tigakub/qd-project/QD_V1.0_BOM.pdf

### Core Materials

Part ID | Picture | Item | Description | Source Link | Price | Quantity | Subtotal | Total
A Arduino MKR | | Wifi 1010 | Microcontroller | Arduino (https://store-usa.arduino.cc/products/arduino-mkr-wifi-1010?queryID=undefined&selectedStore=us) | $32.81 | 1 | $32.81
B | | Dynamixel Shield for Arduino MKR Series | Servo driver board | Robotis (https://www.robotis.us/controllers-2/) | $19.10 | 1 | $19.10

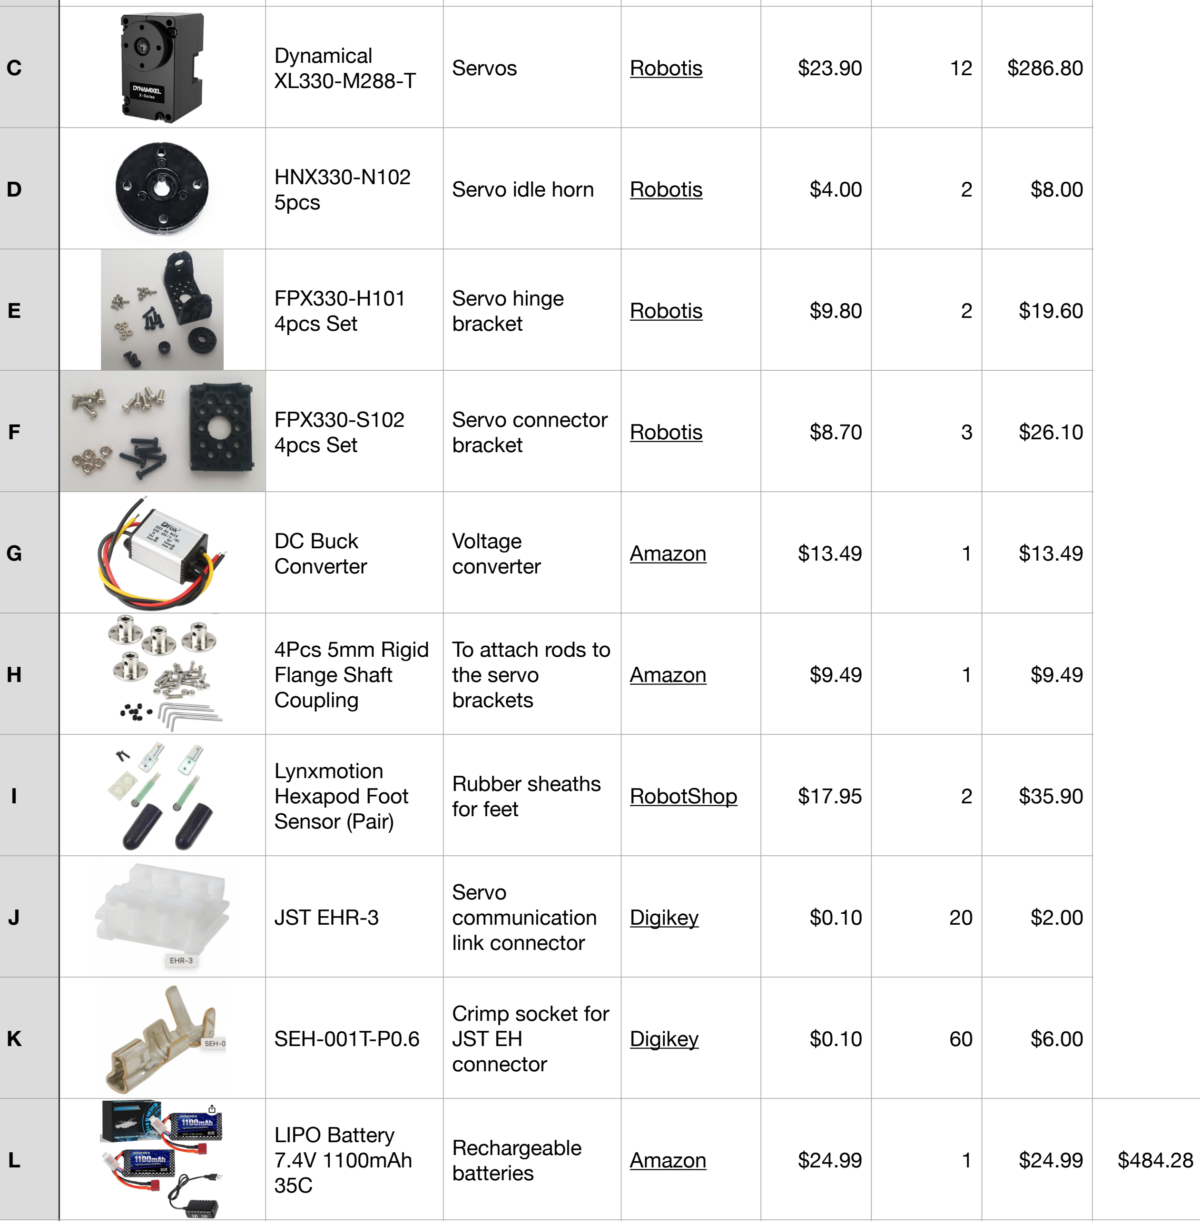
[picture p1: figure]
C Dynamical; Servos; Robotis (https://www.robotis.us/dynamixel-xl330-m288-t/); D HNX330-N102; 5pcs; Servo idle horn; Robotis (https://www.robotis.us/horns/); E FPX330-H101; 4pcs Set; Servo hinge bracket; Robotis (https://www.robotis.us/frames/); F FPX330-S102; Servo connector bracket; G DC Buck; Converter; Voltage converter; Amazon (https://www.amazon.com/gp/product/B00C0KL1OM/ref=ppx_yo_dt_b_search_asin_image?ie=UTF8&th=1); Lynxmotion Hexapod Foot Sensor (Pair); Rubber sheaths for feet; RobotShop (https://www.robotshop.com/products/lynxmotion-hexapod-foot-sensor-pair); J JST EHR-3; Servo communication link connector; Digikey (https://www.digikey.com/en/products/detail/jst-sales-america-inc/EHR-3/527225); LIPO Battery 7.4V 1100mAh 35C; Rechargeable batteries; Amazon (https://www.amazon.com/gp/product/B08N4RHMNH/ref=ppx_yo_dt_b_search_asin_title?ie=UTF8&th=1)

H | | 4Pcs 5mm Rigid Flange Shaft Coupling | To attach rods to the servo brackets | Amazon (https://www.amazon.com/gp/product/B07L1FMBBC/ref=ppx_yo_dt_b_search_asin_title?ie=UTF8&psc=1) | $9.49 | 1 | $9.49
K SEH-001T-P0.6 | | | Crimp socket for JST EH connector | Digikey (https://www.digikey.com/en/products/detail/jst-sales-america-inc/SEH-001T-P0-6/527267) | $0.10 | 60 | $6.00

### QD V1.0 BOM

1

### Bulk Materials

Part ID | Picture | Item | Description | Source Link | Price | Quantity | Subtotal | Total

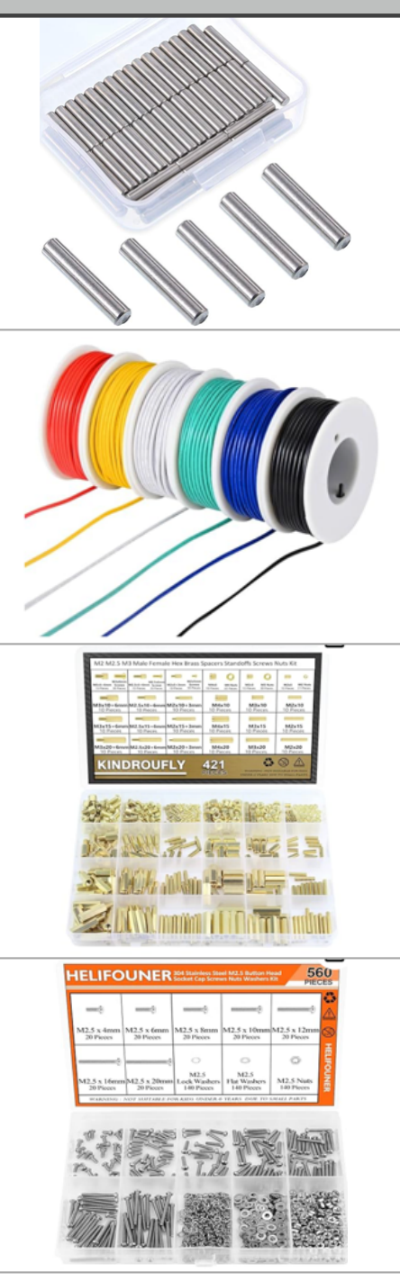
[picture p2: figure]

M | | 50Pcs 5mm x 25mm Dowel Pin Shelf Support Pegs | Steel rods for feet | Amazon (https://www.amazon.com/gp/product/B07FFNTDQF/ref=ppx_yo_dt_b_search_asin_title?ie=UTF8&th=1) | $8.99 | 1 | $8.99
N | | 22 AWG Wire | Electrical wire | Amazon (https://www.amazon.com/gp/product/B0815ZDD5H/ref=ppx_yo_dt_b_search_asin_title?ie=UTF8&th=1) | $14.99 | 1 | $14.99
O | | 421 Pieces M2 M2.5 M3 Male Female Hex Standoffs | Spacers to mount controller and buck converter | Amazon (https://www.amazon.com/gp/product/B0B3Y49J37/ref=ppx_yo_dt_b_search_asin_title?ie=UTF8&th=1) | $22.99 | 1 | $22.99
P | | 560 piece button head socket cap metric screws washers and | Screws washers nuts | Amazon (https://www.amazon.com/gp/product/B0B6HX3798/ref=ppx_yo_dt_b_search_asin_title?ie=UTF8&th=1) | $11.99 | 1 | $11.99 | $58.96

nuts
$543.24

### QD V1.0 BOM

2
