tigakub/qd-project/model/Torso_Hull.stl

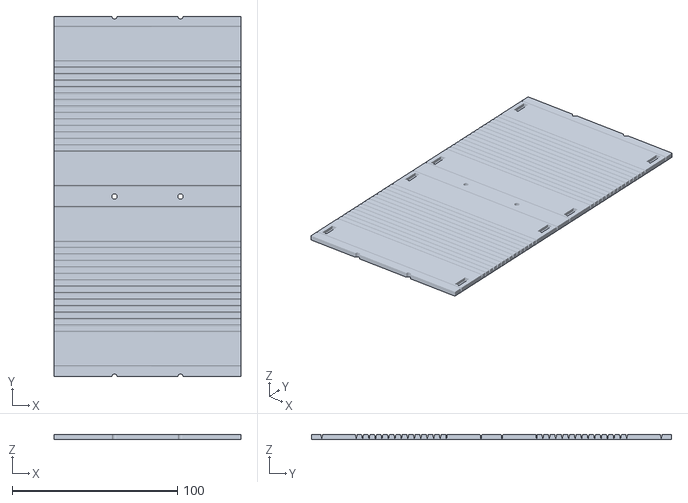
[picture p3: CAD file, 2023-11-29]
model/Torso_Hull.stl
113.0 x 218.1 x 3.00
