tigakub/qd-project/model/Foot.stl

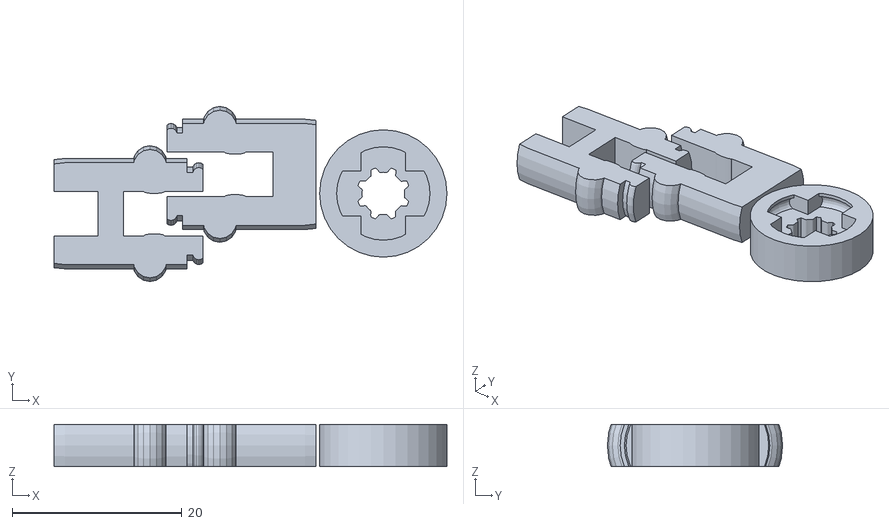
[picture p4: CAD file, 2023-11-29]
model/Foot.stl
46.3 x 20.6 x 5.00
