tigakub/qd-project/model/Central_Frame.stl

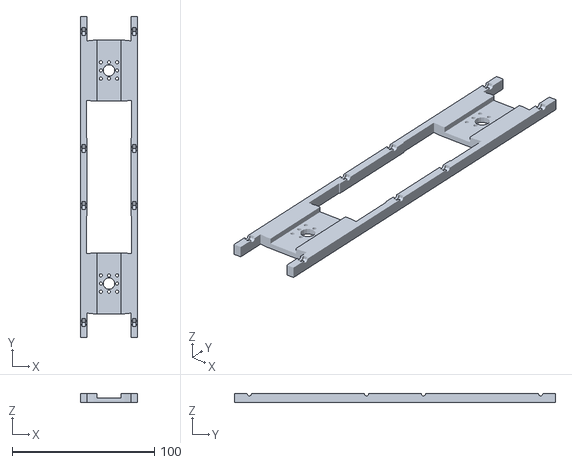
[picture p5: CAD file, 2023-11-29]
model/Central_Frame.stl
40.0 x 225.9 x 6.00
