tigakub/qd-project/model/Torso_End_Caps.stl

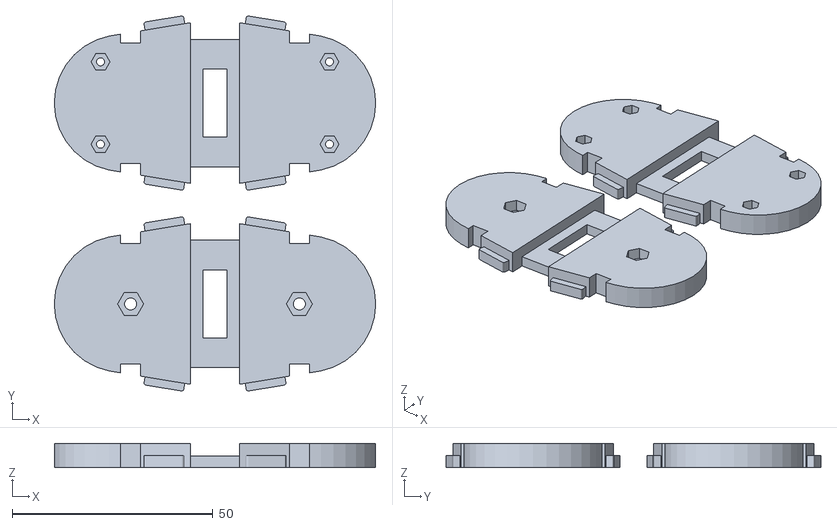
[picture p6: CAD file, 2023-11-29]
model/Torso_End_Caps.stl
80.0 x 93.3 x 6.00
