tigakub/qd-project/model/Head_Tail_Hull.stl

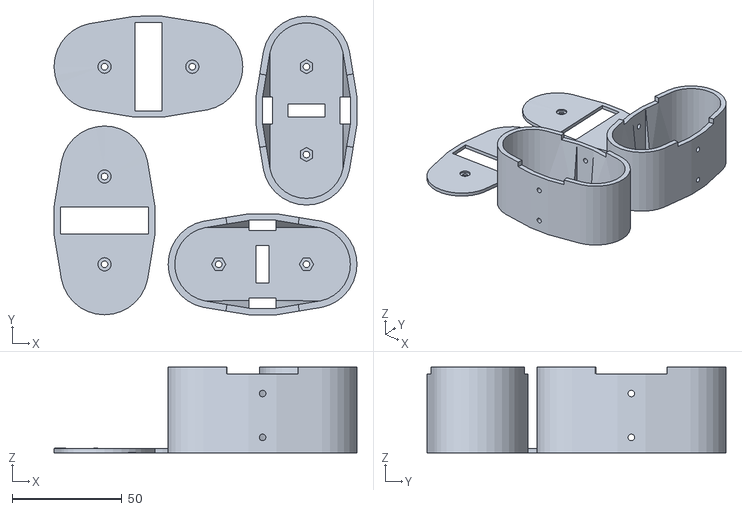
[picture p7: CAD file, 2023-11-29]
model/Head_Tail_Hull.stl
138.0 x 136.0 x 39.0
