tigakub/qd-project/model/Tail_Cap.stl

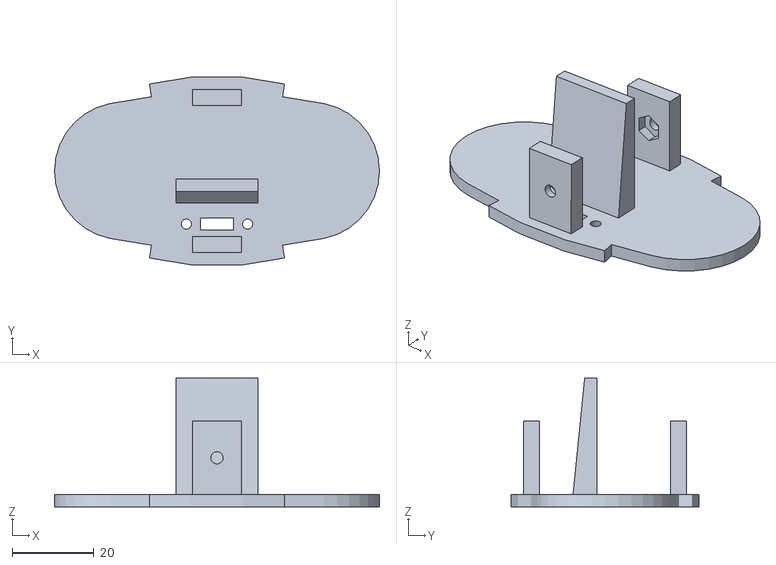
[picture p8: CAD file, 2023-11-29]
model/Tail_Cap.stl
79.7 x 46.0 x 31.5
