tigakub/qd-project/model/Head_Cap.stl

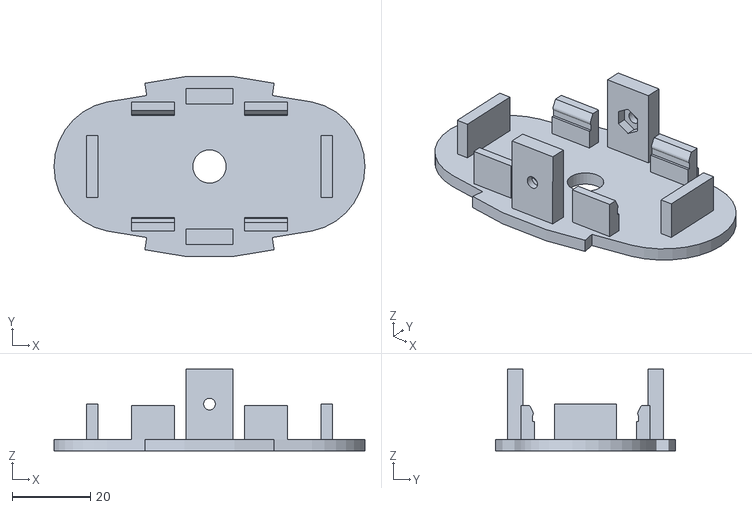
[picture p9: CAD file, 2023-11-29]
model/Head_Cap.stl
79.7 x 46.0 x 21.0
