tigakub/qd-project/model/Head_and_Tail_Hull.stl

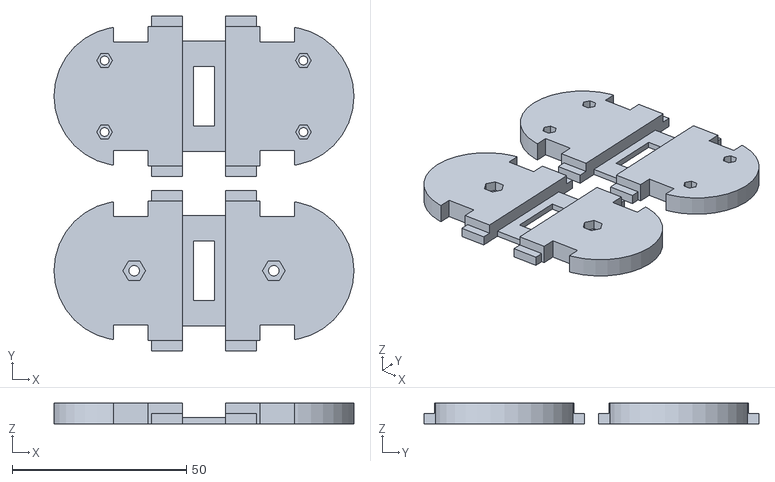
[picture p10: CAD file, 2023-11-29]
model/Head_and_Tail_Hull.stl
86.0 x 96.0 x 6.00
