tigakub/qd-project/(commit log)

2024-03-22 Rename Bendy_Hull.stl to Torso_Hull.stl
    Making naming consistent.
    [Torso_Hull.stl]
2024-03-22 Rename Body_End_Caps.stl to Torso_End_Caps.stl
    Naming consistency
    [Torso_End_Caps.stl]
